ryfu2/Fall2024ECE445Team33/README.md

# Fall2024ECE445Team33
We are Team33 and this is our git repo for our ECE445 project:

AMADEUS

Augmented Modular AI Dialogue and Exchange User System 

It contains all the files/codes we have created and notes we have taken

There are more details in our design document, feel free to look around!
