ryfu2/Fall2024ECE445Team33/Python_code/wav_receiver/README.md

This code is for receiving wav file from the board through serial port.

It is used to verify that we packed input audio into a wav file correctly.
