ryfu2/Fall2024ECE445Team33/Documents/ECE445 Components.xlsx

Component | Functionality | Data Sheet | Purchase Link
ESP32-S3-WROOM-1 | ESP32 Microprocessor | https://www.espressif.com/sites/ default/files/documentation/ esp32-s3-wroom-1_wroom-1u_datasheet_en.pdf (https://www.espressif.com/sites/default/files/documentation/esp32-s3-wroom-1_wroom-1u_datasheet_en.pdf) | https://www.digikey.com/en/products/detail/espressif-systems/ ESP32-S3-WROOM-1-N8/15200089
TC1262 - 33 | 5V - 3.3V LDO | http://ww1.microchip.com/downloads/ en/DeviceDoc/21373C.pdf (http://ww1.microchip.com/downloads/en/DeviceDoc/21373C.pdf) | https://www.digikey.com/en/products/detail/ microchip-technology/TC1262-3-3VDBTR/443194
USB4085 | USBC Receptacle | https://gct.co/files/drawings/usb4085.pdf | https://www.digikey.com/en/products/detail/gct/USB4085-GF-A/9859662
INMP441 | Microphone | https://invensense.tdk.com/wp-content/ uploads/2015/02/INMP441.pdf | https://www.digikey.com/en/products/detail/tdk-invensense/INMP441ACEZ-R7/2793284
MAX98357A | Digital Audio Amplifier | https://www.analog.com/media/en/technical- documentation/data-sheets/max98357a-max98357b.pdf | https://www.digikey.com/en/products/detail/ analog-devices-inc-maxim-integrated/MAX98357AETE-T/4936122
LCD 1602 | LCD Display | https://universal-solder.ca/downloads/ canaduino_lcd_1602_datasheet.pdf | https://www.digikey.com/en/products/detail/universal-solder-electronics-ltd/ LCD-1602-2x16-Blue-White/16821383 (https://www.waveshare.com/datasheet/LCD_en_PDF/LCD1602.pdf)
OLED 128x64 1.3" I2C | 128 * 64 OLED Display | https://universal-solder.ca/downloads/ canaduino_oled_1.3_i2c.pdf | https://www.digikey.com/en/products/detail/universal-solder-electronics-ltd/ OLED-128x64-1-3-I2C/16822118
333028 | Serial Debug Port | https://mm.digikey.com/Volume0/opasdata/d220001/medias/docus/ 5858/333028%20USB%20UART%20CH340%20converter %20board%20datasheet.pdf?_gl=1*1krdu72*_up*MQ..&g clid=Cj0KCQjwu-63BhC9ARIsAMMTLXQhOa8hMw5uQejYv3aZm1 JxY8sn3Z-aL62KJKSncHDBArILaI2MEHUaAsvMEALw_wcB | https://www.digikey.com/en/products/detail/soldered-electronics/333028/21720459?gad_source=1
SP-1504 | Speaker | https://www.soberton.com/wp-content/uploads/2018/07/SP-1504-June-2018.pdf | https://www.digikey.com/en/products/detail/soberton-inc/SP-1504/3973690
Useful Links
Title | Link
Sound with ESP32 – I2S Protocol | https://dronebotworkshop.com/esp32-i2s/
ThingPulse OLED SSD1306 (ESP8266/ESP32/Mbed-OS) | https://github.com/ThingPulse/ esp8266-oled-ssd1306 (https://github.com/ThingPulse/esp8266-oled-ssd1306)
