ryfu2/Fall2024ECE445Team33/Arduino_code/microphone_input_wav_test/README.md

This is the Arduino code for testing audio input and wav file packaging.

It takes in audio input from microphone through I2S, package it into a wav file and send it through serial port.

Wav_receiver python file (serial_savewav.py) should be used to receive data from serial port to verify the wav file's validity.
