ryfu2/Fall2024ECE445Team33/Arduino_code/sine_wave_speaker_test/README.md

This is the Arduino code for test speaker audio output. 

It generates a sine wave signal and send it through I2S to the speaker.
