ryfu2/Fall2024ECE445Team33/Python_code/server_test/README.md

This code is for testing our AI server by sending requests to the server.

Input audio file is named 'record_out.wav' and response will be stored in 'response.wav'.
