ryfu2/Fall2024ECE445Team33/PCB/final_project/final_project_v0.1/final_project_v0.1.kicad_pcb

## KiCad design PCB/final_project/final_project_v0.1/final_project_v0.1.kicad_pcb (2024-12-04)

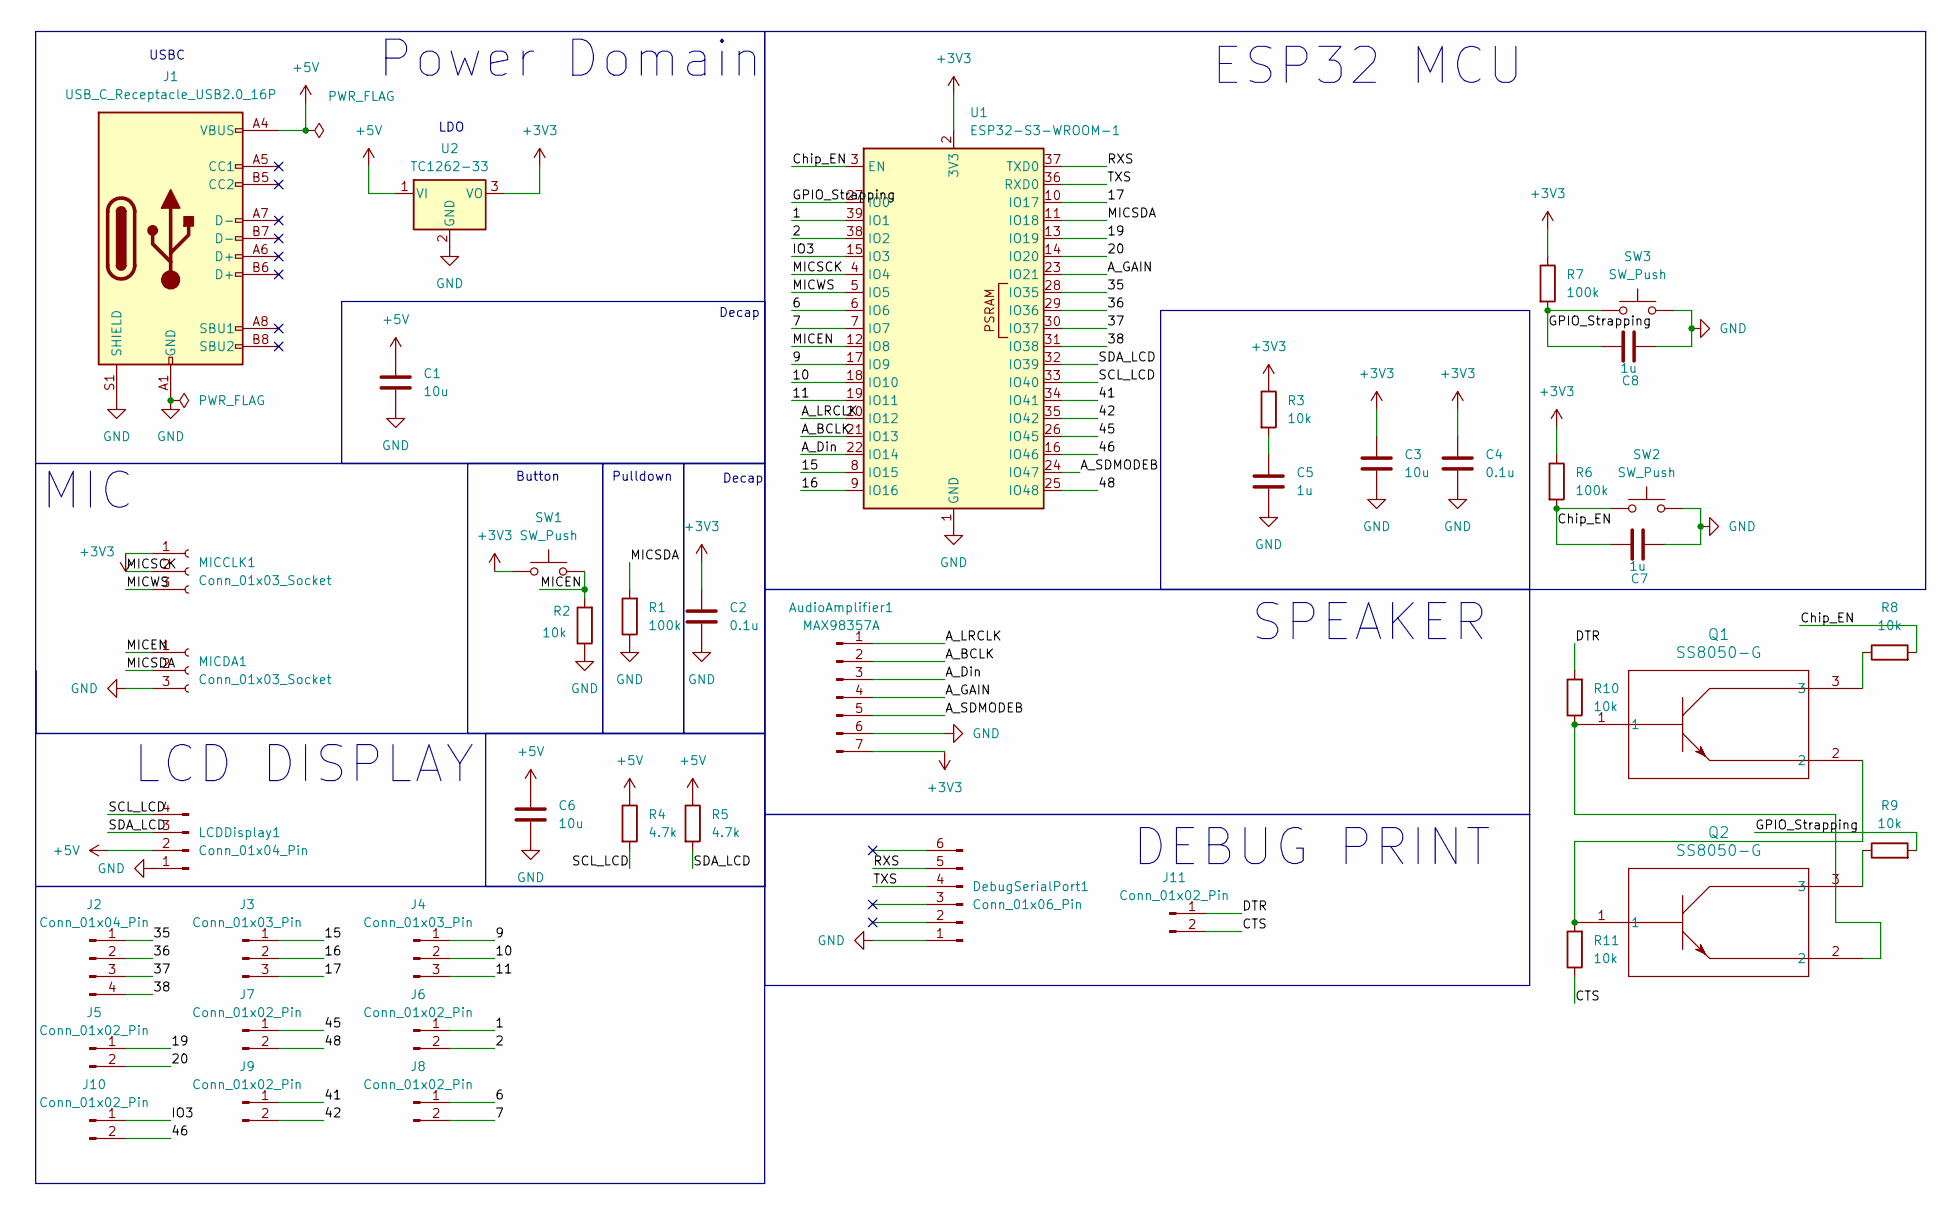
[picture p6: schematic final_project_v0.1.kicad_sch]

Parts:
AudioAmplifier1: MAX98357A; PinHeader_1x07_P2.54mm_Vertical
C1, C3, C6: 10u; C_0805_2012Metric_Pad1.18x1.45mm_HandSolder
C2, C4: 0.1u; C_0805_2012Metric_Pad1.18x1.45mm_HandSolder
C5, C7, C8: 1u; C_0805_2012Metric_Pad1.18x1.45mm_HandSolder
DebugSerialPort1: Conn_01x06_Pin; PinHeader_1x06_P2.54mm_Vertical
J1: USB_C_Receptacle_USB2.0_16P; USB_C_Receptacle_GCT_USB4085
J2: Conn_01x04_Pin; PinHeader_1x04_P2.54mm_Vertical
J3, J4: Conn_01x03_Pin; PinHeader_1x03_P2.54mm_Vertical
J5, J6, J7, J8, J9, J10, J11: Conn_01x02_Pin; PinHeader_1x02_P2.54mm_Vertical
LCDDisplay1: Conn_01x04_Pin; PinHeader_1x04_P2.54mm_Vertical
MICCLK1: Conn_01x03_Socket; PinHeader_1x03_P2.54mm_Vertical
MICDA1: Conn_01x03_Socket; PinHeader_1x03_P2.54mm_Vertical
Q1, Q2: SS8050-G; TRAN_SS8050-G_CIP
R1, R6, R7: 100k; R_0805_2012Metric_Pad1.20x1.40mm_HandSolder
R2, R3, R8, R9, R10, R11: 10k; R_0805_2012Metric_Pad1.20x1.40mm_HandSolder
R4, R5: 4.7k; R_0805_2012Metric_Pad1.20x1.40mm_HandSolder
SW1, SW2, SW3: SW_Push; SW_PUSH_6mm_H4.3mm
U1: ESP32-S3-WROOM-1
U2: TC1262-33; SOT-223-3_TabPin2

Connections:
+3V3: AudioAmplifier1.7, C2.1, C3.1, C4.1, MICCLK1.1, R3.1, R6.1, R7.1, SW1.1, U1.2 (3V3), U2.3 (VO)
+5V: C1.1, C6.1, J1.A4 (VBUS), J1.A9 (VBUS), J1.B4 (VBUS), J1.B9 (VBUS), LCDDisplay1.2, R4.1, R5.1, U2.1 (VI)
/1: J6.1, U1.39 (IO1)
/2: J6.2, U1.38 (IO2)
/6: J8.1, U1.6 (IO6)
/7: J8.2, U1.7 (IO7)
/9: J4.1, U1.17 (IO9)
/10: J4.2, U1.18 (IO10)
/11: J4.3, U1.19 (IO11)
/15: J3.1, U1.8 (IO15)
/16: J3.2, U1.9 (IO16)
/17: J3.3, U1.10 (IO17)
/19: J5.1, U1.13 (IO19)
/20: J5.2, U1.14 (IO20)
/35: J2.1, U1.28 (IO35)
/36: J2.2, U1.29 (IO36)
/37: J2.3, U1.30 (IO37)
/38: J2.4, U1.31 (IO38)
/41: J9.1, U1.34 (IO41)
/42: J9.2, U1.35 (IO42)
/45: J7.1, U1.26 (IO45)
/46: J10.2, U1.16 (IO46)
/48: J7.2, U1.25 (IO48)
/A_BCLK: AudioAmplifier1.2, U1.21 (IO13)
/A_Din: AudioAmplifier1.3, U1.22 (IO14)
/A_GAIN: AudioAmplifier1.4, U1.23 (IO21)
/A_LRCLK: AudioAmplifier1.1, U1.20 (IO12)
/A_SDMODEB: AudioAmplifier1.5, U1.24 (IO47)
/CTS: J11.2, R11.1
/Chip_EN: C7.1, R6.2, R8.2, SW2.1, U1.3 (EN)
/DTR: J11.1, R10.2
/GPIO_Strapping: C8.1, R7.2, R9.2, SW3.1, U1.27 (IO0)
/IO3: J10.1, U1.15 (IO3)
/MICEN: MICDA1.1, R2.2, SW1.2, U1.12 (IO8)
/MICSCK: MICCLK1.2, U1.4 (IO4)
/MICSDA: MICDA1.2, R1.2, U1.11 (IO18)
/MICWS: MICCLK1.3, U1.5 (IO5)
/RXS: DebugSerialPort1.5, U1.37 (TXD0)
/SCL_LCD: LCDDisplay1.4, R4.2, U1.33 (IO40)
/SDA_LCD: LCDDisplay1.3, R5.2, U1.32 (IO39)
/TXS: DebugSerialPort1.4, U1.36 (RXD0)
GND: AudioAmplifier1.6, C1.2, C2.2, C3.2, C4.2, C5.2, C6.2, C7.2, C8.2, DebugSerialPort1.1, J1.A1 (GND), J1.A12 (GND), J1.B1 (GND), J1.B12 (GND), J1.S1 (SHIELD), LCDDisplay1.1, MICDA1.3, R1.1, R2.1, SW2.2, SW3.2, U1.1 (GND), U1.40 (GND), U1.41 (GND), U2.2 (GND)
unnamed: C5.1, R3.2
unnamed: Q1.1, Q2.2, R10.1
unnamed: Q1.2, Q2.1, R11.2
unnamed: Q1.3, R8.1
unnamed: Q2.3, R9.1

Notes on the sheet:
LCD DISPLAY
Decap
Power Domain
Button
USBC
ESP32 MCU
MIC
LDO
SPEAKER
DEBUG PRINT
Pulldown

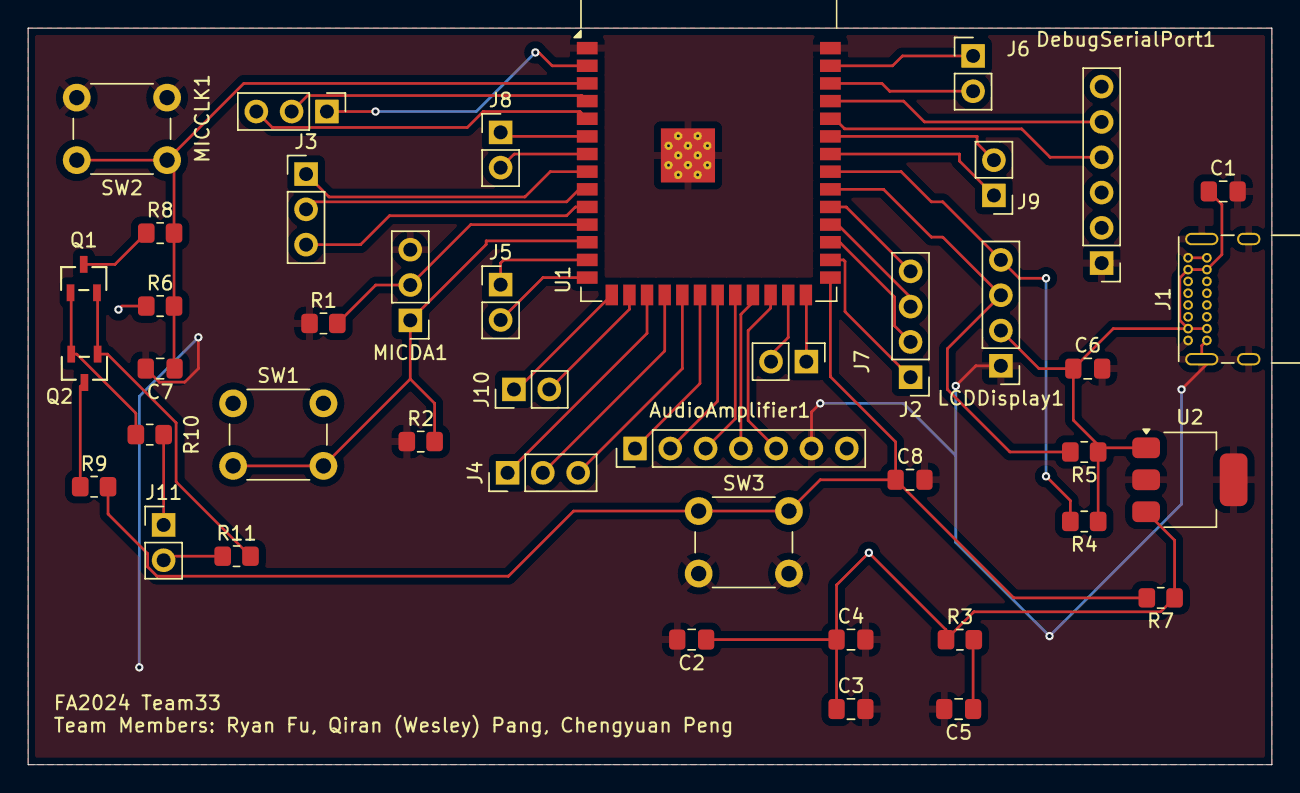
[picture p7: board final_project_v0.1.kicad_pcb from above]

Board: 2 copper layers, 89.5 x 53.0 mm, 42 parts (0 on the bottom side), 47 nets.
