ryfu2/Fall2024ECE445Team33/Arduino_code/final_code/oled.cpp

#include <Arduino.h>
#include "oled.h"

static const uint8_t oled_font6x8 [] PROGMEM = {
    0x00, 0x00, 0x00, 0x00, 0x00, 0x00, // sp
    0x00, 0x00, 0x00, 0x2f, 0x00, 0x00, // !
    0x00, 0x00, 0x07, 0x00, 0x07, 0x00, // "
    0x00, 0x14, 0x7f, 0x14, 0x7f, 0x14, // #
    0x00, 0x24, 0x2a, 0x7f, 0x2a, 0x12, // $
    0x00, 0x62, 0x64, 0x08, 0x13, 0x23, // %
    0x00, 0x36, 0x49, 0x55, 0x22, 0x50, // &
    0x00, 0x00, 0x05, 0x03, 0x00, 0x00, // '
    0x00, 0x00, 0x1c, 0x22, 0x41, 0x00, // (
    0x00, 0x00, 0x41, 0x22, 0x1c, 0x00, // )
    0x00, 0x14, 0x08, 0x3E, 0x08, 0x14, // *
    0x00, 0x08, 0x08, 0x3E, 0x08, 0x08, // +
    0x00, 0x00, 0x00, 0xA0, 0x60, 0x00, // ,
    0x00, 0x08, 0x08, 0x08, 0x08, 0x08, // -
    0x00, 0x00, 0x60, 0x60, 0x00, 0x00, // .
    0x00, 0x20, 0x10, 0x08, 0x04, 0x02, // /
    0x00, 0x3E, 0x51, 0x49, 0x45, 0x3E, // 0
    0x00, 0x00, 0x42, 0x7F, 0x40, 0x00, // 1
    0x00, 0x42, 0x61, 0x51, 0x49, 0x46, // 2
    0x00, 0x21, 0x41, 0x45, 0x4B, 0x31, // 3
    0x00, 0x18, 0x14, 0x12, 0x7F, 0x10, // 4
    0x00, 0x27, 0x45, 0x45, 0x45, 0x39, // 5
    0x00, 0x3C, 0x4A, 0x49, 0x49, 0x30, // 6
    0x00, 0x01, 0x71, 0x09, 0x05, 0x03, // 7
    0x00, 0x36, 0x49, 0x49, 0x49, 0x36, // 8
    0x00, 0x06, 0x49, 0x49, 0x29, 0x1E, // 9
    0x00, 0x00, 0x36, 0x36, 0x00, 0x00, // :
    0x00, 0x00, 0x56, 0x36, 0x00, 0x00, // ;
    0x00, 0x08, 0x14, 0x22, 0x41, 0x00, // <
    0x00, 0x14, 0x14, 0x14, 0x14, 0x14, // =
    0x00, 0x00, 0x41, 0x22, 0x14, 0x08, // >
    0x00, 0x02, 0x01, 0x51, 0x09, 0x06, // ?
    0x00, 0x32, 0x49, 0x59, 0x51, 0x3E, // @
    0x00, 0x7C, 0x12, 0x11, 0x12, 0x7C, // A
    0x00, 0x7F, 0x49, 0x49, 0x49, 0x36, // B
    0x00, 0x3E, 0x41, 0x41, 0x41, 0x22, // C
    0x00, 0x7F, 0x41, 0x41, 0x22, 0x1C, // D
    0x00, 0x7F, 0x49, 0x49, 0x49, 0x41, // E
    0x00, 0x7F, 0x09, 0x09, 0x09, 0x01, // F
    0x00, 0x3E, 0x41, 0x49, 0x49, 0x7A, // G
    0x00, 0x7F, 0x08, 0x08, 0x08, 0x7F, // H
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
    0x02, 0x04, 0x08, 0x10, 0x20, 0x00, // backslash
    0x00, 0x00, 0x41, 0x41, 0x7F, 0x00, // ]
    0x00, 0x04, 0x02, 0x01, 0x02, 0x04, // ^
    0x00, 0x40, 0x40, 0x40, 0x40, 0x40, // _
    0x00, 0x00, 0x01, 0x02, 0x04, 0x00, // '
    0x00, 0x20, 0x54, 0x54, 0x54, 0x78, // a
    0x00, 0x7F, 0x48, 0x44, 0x44, 0x38, // b
    0x00, 0x38, 0x44, 0x44, 0x44, 0x20, // c
    0x00, 0x38, 0x44, 0x44, 0x48, 0x7F, // d
    0x00, 0x38, 0x54, 0x54, 0x54, 0x18, // e
    0x00, 0x08, 0x7E, 0x09, 0x01, 0x02, // f
    0x00, 0x18, 0xA4, 0xA4, 0xA4, 0x7C, // g
    0x00, 0x7F, 0x08, 0x04, 0x04, 0x78, // h
    0x00, 0x00, 0x44, 0x7D, 0x40, 0x00, // i
    0x00, 0x40, 0x80, 0x84, 0x7D, 0x00, // j
    0x00, 0x7F, 0x10, 0x28, 0x44, 0x00, // k
    0x00, 0x00, 0x41, 0x7F, 0x40, 0x00, // l
    0x00, 0x7C, 0x04, 0x18, 0x04, 0x78, // m
    0x00, 0x7C, 0x08, 0x04, 0x04, 0x78, // n
    0x00, 0x38, 0x44, 0x44, 0x44, 0x38, // o
    0x00, 0xFC, 0x24, 0x24, 0x24, 0x18, // p
    0x00, 0x18, 0x24, 0x24, 0x18, 0xFC, // q
    0x00, 0x7C, 0x08, 0x04, 0x04, 0x08, // r
    0x00, 0x48, 0x54, 0x54, 0x54, 0x20, // s
    0x00, 0x04, 0x3F, 0x44, 0x40, 0x20, // t
    0x00, 0x3C, 0x40, 0x40, 0x20, 0x7C, // u
    0x00, 0x1C, 0x20, 0x40, 0x20, 0x1C, // v
    0x00, 0x3C, 0x40, 0x30, 0x40, 0x3C, // w
    0x00, 0x44, 0x28, 0x10, 0x28, 0x44, // x
    0x00, 0x1C, 0xA0, 0xA0, 0xA0, 0x7C, // y
    0x00, 0x44, 0x64, 0x54, 0x4C, 0x44, // z
    0x00, 0x00, 0x08, 0x77, 0x41, 0x00, // {
    0x00, 0x00, 0x00, 0x63, 0x00, 0x00, // ¦
    0x00, 0x00, 0x41, 0x77, 0x08, 0x00, // }
    0x00, 0x08, 0x04, 0x08, 0x08, 0x04, // ~
    0x00, 0x3D, 0x40, 0x40, 0x20, 0x7D, // ü
    0x00, 0x3D, 0x40, 0x40, 0x40, 0x3D, // Ü
    0x00, 0x21, 0x54, 0x54, 0x54, 0x79, // ä
    0x00, 0x7D, 0x12, 0x11, 0x12, 0x7D, // Ä
    0x00, 0x39, 0x44, 0x44, 0x44, 0x39, // ö
    0x00, 0x3D, 0x42, 0x42, 0x42, 0x3D, // Ö
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
};

OLED::OLED(uint8_t sda_pin, uint8_t scl_pin, uint8_t reset_pin, uint8_t i2c_address, uint_fast8_t width, uint_fast8_t height, bool isSH1106) :
sda_pin(sda_pin),
scl_pin(scl_pin),
reset_pin(reset_pin),
width(width),
height(height),
i2c_address(i2c_address),
pages((height + 7) / 8),
bufsize(static_cast<uint_least16_t> (pages*width))
{
    this->buffer = (uint8_t *) malloc(bufsize); // two dimensional array of n pages each of n columns.
    X=0;
    Y=0;
    ttyMode=OLED_DEFAULT_TTY_MODE;
    if (isSH1106) {
        displayController=CTRL_SH1106;
    }
    else {
        displayController=CTRL_SSD1306;
    }
    fontInverted=false;
    usingOffset=false;
}

OLED::OLED(uint8_t sda_pin, uint8_t scl_pin, uint8_t reset_pin, tWidth width, tHeight height, tDisplayCtrl displayCtrl, uint8_t i2c_address) :
sda_pin(sda_pin),
scl_pin(scl_pin),
reset_pin(reset_pin),
width(width),
height(height),
i2c_address(i2c_address),
displayController(displayCtrl),
pages((height + 7) / 8),
bufsize(static_cast<uint_least16_t> (pages*width))
{
    this->buffer = (uint8_t *) malloc(bufsize); // two dimensional array of n pages each of n columns.
    X=0;
    Y=0;
    ttyMode=OLED_DEFAULT_TTY_MODE;
    fontInverted=false;
    usingOffset=false;
}

OLED::~OLED()
{
    free(buffer);
}

void OLED::i2c_start()
{
    while (!digitalRead(sda_pin) || !digitalRead(scl_pin));
    digitalWrite(sda_pin, LOW);
    #if !defined OUTPUT_OPEN_DRAIN
        pinMode(sda_pin, OUTPUT);
    #endif
        OLED_I2C_DELAY;
        digitalWrite(scl_pin, LOW);
    #if !defined OUTPUT_OPEN_DRAIN
        pinMode(scl_pin, OUTPUT);
    #endif
    OLED_I2C_DELAY;
}

void OLED::i2c_stop()
{
    #if !defined OUTPUT_OPEN_DRAIN
        pinMode(scl_pin, INPUT);
    #endif
        digitalWrite(scl_pin, HIGH);
        OLED_I2C_DELAY;
    #if !defined OUTPUT_OPEN_DRAIN
        pinMode(sda_pin, INPUT);
    #endif
    digitalWrite(sda_pin, HIGH);
    OLED_I2C_DELAY;
    while (!digitalRead(sda_pin) || !digitalRead(scl_pin));
}

bool OLED::i2c_send(uint8_t byte)
{
    for (int_fast8_t bit = 7; bit >= 0; bit--)
    {
        if (byte & 128)
        {
        #if !defined OUTPUT_OPEN_DRAIN
                    pinMode(sda_pin, INPUT);
        #endif
                    digitalWrite(sda_pin, HIGH);
                }
                else
                {
                    digitalWrite(sda_pin, LOW);
        #if !defined OUTPUT_OPEN_DRAIN
                    pinMode(sda_pin, OUTPUT);
        #endif
        }
        OLED_I2C_DELAY;
        #if !defined OUTPUT_OPEN_DRAIN
                pinMode(scl_pin, INPUT);
        #endif
                digitalWrite(scl_pin, HIGH);        
                OLED_I2C_DELAY;
                while (!digitalRead(scl_pin)); 
                digitalWrite(scl_pin, LOW);
        #if !defined OUTPUT_OPEN_DRAIN
                pinMode(scl_pin, OUTPUT);
        #endif
        OLED_I2C_DELAY;
        byte = byte << 1;
    }
    // Receive ACK
    #if !defined OUTPUT_OPEN_DRAIN
        pinMode(sda_pin, INPUT);
    #endif
        digitalWrite(sda_pin, HIGH);
    #if !defined OUTPUT_OPEN_DRAIN
        pinMode(scl_pin, INPUT);
    #endif
    digitalWrite(scl_pin, HIGH);    
    OLED_I2C_DELAY;
    while (!digitalRead(scl_pin)); 
    bool ack = digitalRead(sda_pin) == 0;    
    digitalWrite(scl_pin, LOW);
    #if !defined OUTPUT_OPEN_DRAIN
        pinMode(scl_pin, OUTPUT);
    #endif
    OLED_I2C_DELAY;
    return ack;
}

void OLED::begin()
{
    #if defined OUTPUT_OPEN_DRAIN
        pinMode(sda_pin, OUTPUT_OPEN_DRAIN);
        digitalWrite(sda_pin, HIGH);
        pinMode(scl_pin, OUTPUT_OPEN_DRAIN);
        digitalWrite(scl_pin, HIGH);
    #else
        pinMode(sda_pin, INPUT);
        pinMode(scl_pin, INPUT);
    #endif
    if (reset_pin != NO_RESET_PIN)
    {
        pinMode(reset_pin, OUTPUT);
        digitalWrite(reset_pin, LOW);
        delay(10);
        digitalWrite(reset_pin, HIGH);
    }
    delay(100);
    i2c_start();
    i2c_send(i2c_address << 1); // address + write
    i2c_send(0x00); // command
    i2c_send(0xAE); // display off
    i2c_send(0xD5); // clock divider
    i2c_send(0x80); 
    i2c_send(0xA8); // multiplex ratio
    i2c_send(height - 1); 
    i2c_send(0xD3); // no display offset
    i2c_send(0x00); 
    i2c_send(0x40); // start line address=0
    i2c_send(0x8D); // enable charge pump
    i2c_send(0x14); 
    i2c_send(0x20); // memory adressing mode=horizontal
    i2c_send(0x00); 
    i2c_send(0xA1); // segment remapping mode
    i2c_send(0xC8); // COM output scan direction
    if (width == 128 && height == 32)
    {
        i2c_send(0xDA); // com pins hardware configuration
        i2c_send(0x02); 
    }
    else if (width == 128 && height == 64)
    {
        i2c_send(0xDA); // com pins hardware configuration
        i2c_send(0x12); 
    }
    else if (width == 96 && height == 16)
    {
        i2c_send(0xDA); // com pins hardware configuration
        i2c_send(0x02); 
    }
    i2c_send(0x81); // contrast control
    i2c_send(0x80);
    i2c_send(0xD9); // pre-charge period
    i2c_send(0x22); 
    i2c_send(0xDB); // set vcomh deselect level
    i2c_send(0x20); 
    i2c_send(0xA4); // output RAM to display
    i2c_send(0xA6); // display mode A6=normal, A7=inverse
    i2c_send(0x2E); // stop scrolling
    i2c_stop();
    delay(100);

    // Clear and send buffer
    display();
    clear();
    display();

    // Switch display on
    set_power(true);
}

void OLED::set_power(bool enable)
{
    i2c_start();
    i2c_send(i2c_address << 1); // address + write
    i2c_send(0x00); // command
    if (enable)
    {
        i2c_send(0x8D); // enable charge pump
        i2c_send(0x14);
        i2c_send(0xAF); // display on
    }
    else
    {
        i2c_send(0xAE); // display off
        i2c_send(0x8D); // disable charge pump
        i2c_send(0x10);
    }
    i2c_stop();
}

void OLED::set_invert(bool enable)
{
    i2c_start();
    i2c_send(i2c_address << 1); // address + write
    i2c_send(0x00); // command
    if (enable)
    {
        i2c_send(0xA7); // invert display
    }
    else
    {
        i2c_send(0xA6); // normal display
    }
    i2c_stop();
}

void OLED::set_scrolling(tScrollEffect scroll_type, uint_fast8_t first_page, uint_fast8_t last_page)
{
    i2c_start();
    i2c_send(i2c_address << 1); // address + write
    i2c_send(0x00); // command
    i2c_send(0x2E); // deativate scroll
    if (scroll_type == DIAGONAL_LEFT || scroll_type == DIAGONAL_RIGHT)
    {
        i2c_send(0xA3); // vertical scroll area
        i2c_send(0x00);
        i2c_send(height - 1);
    }
    if (scroll_type != NO_SCROLLING)
    {
        i2c_send(scroll_type);
        i2c_send(0x00); // dummy byte
        i2c_send(first_page);
        i2c_send(0x00); // time interval
        i2c_send(last_page);
        if (scroll_type == DIAGONAL_LEFT || scroll_type == DIAGONAL_RIGHT)
        {
            i2c_send(0x01); // vertical scrolling speed
        }
        else
        {
            i2c_send(0x00); // dummy byte
            i2c_send(0xFF); // dummy byte
        }
        i2c_send(0x2F); // ativate scroll
    }
    i2c_stop();
}

void OLED::set_contrast(uint8_t contrast)
{
    i2c_start();
    i2c_send(i2c_address << 1); // address + write
    i2c_send(0x00); // command
    i2c_send(0x81); // deativate scrol
    i2c_send(contrast); 
    i2c_stop();
}

void OLED::clear(tColor color)
{
    if (color == WHITE)
    {
        memset(buffer, 0xFF, bufsize);
    }
    else
    {
        memset(buffer, 0x00, bufsize);
    }
    X=0;
    Y=0;
}

void OLED::display()
{
    uint16_t index = 0;
    for (uint_fast8_t page = 0; page < pages; page++)
    {
        // Set memory address to fill
        i2c_start();
        i2c_send(i2c_address << 1); // address + write
        i2c_send(0x00); // command
        if (displayController == CTRL_SH1106)
        {
            i2c_send(0xB0 + page); // set page
            i2c_send(0x00); // lower columns address =0
            i2c_send(0x10); // upper columns address =0
        }
        else
        {
            i2c_send(0xB0 + page); // set page
            i2c_send(0x21); // column address
            i2c_send(0x00); // first column =0
            i2c_send(width - 1); // last column
        }
        i2c_stop();

        // send one page of buffer to the display
        i2c_start();
        i2c_send(i2c_address << 1); // address + write
        i2c_send(0x40); // data
        if(usingOffset){
            i2c_send(0);
            i2c_send(0);
        }
        for (uint_fast8_t column = 0; column < width; column++)
        {
            i2c_send(buffer[index++]);
        }
        i2c_stop();
        yield(); // to avoid that the watchdog triggers
    }
}

void OLED::draw_byte(uint_fast8_t x, uint_fast8_t y, uint8_t b, tColor color)
{
    // Invalid position
    if (x >= width || y >= height)
    {
        return;
    }

    uint_fast16_t buffer_index = y / 8 * width + x;

    if (fontInverted) {
        b^=255;
    }

    if (color == WHITE)
    {
        // If the y position matches a page, then it goes quicker
        if (y % 8 == 0)
        {
            if (buffer_index < bufsize)
            {
                buffer[buffer_index] |= b;
            }
        }
        else
        {
            uint16_t w = (uint16_t) b << (y % 8);
            if (buffer_index < bufsize)
            {
                buffer[buffer_index] |= (w & 0xFF);
            }
            uint16_t buffer_index2 = buffer_index + width;
            if (buffer_index2 < bufsize)
            {
                buffer[buffer_index2] |= (w >> 8);
            }
        }
    }
    else
    {
        // If the y position matches a page, then it goes quicker
        if (y % 8 == 0)
        {
            if (buffer_index < bufsize)
            {
                buffer[buffer_index] &= ~b;
            }
        }
        else
        {
            uint16_t w = (uint16_t) b << (y % 8);
            if (buffer_index < bufsize)
            {
                buffer[buffer_index] &= ~(w & 0xFF);
            }
            uint16_t buffer_index2 = buffer_index + width;
            if (buffer_index2 < bufsize)
            {
                buffer[buffer_index2] &= ~(w >> 8);
            }
        }
    }
    return;
}

void OLED::draw_bytes(uint_fast8_t x, uint_fast8_t y, const uint8_t* data, uint_fast8_t size, tFontScaling scaling, tColor color, bool useProgmem)
{
    for (uint_fast8_t column = 0; column < size; column++)
    {
        uint8_t b;
        if (useProgmem)
        {
            b = pgm_read_byte(data);
        }
        else
        {
            b = *data;
        }
        data++;
        if (scaling == DOUBLE_SIZE)
        {
            // Stretch vertically
            uint16_t w = 0;
            for (uint_fast8_t bit = 0; bit < 7; bit++)
            {
                if (b & (1 << bit))
                {
                    uint_fast8_t pos = bit << 1;
                    w |= ((1 << pos) | (1 << (pos + 1)));
                }
            }

            // Output 2 times to strech hozizontally            
            draw_byte(x, y, w & 0xFF, color);
            draw_byte(x, y + 8, (w >> 8), color);
            x++;
            draw_byte(x, y, w & 0xFF, color);
            draw_byte(x, y + 8, (w >> 8), color);
            x++;
        }
        else // NORMAL_SIZE
        {
            draw_byte(x++, y, b, color);
        }
    }
}

size_t OLED::draw_character(uint_fast8_t x, uint_fast8_t y, char c, tFontScaling scaling, tColor color)
{
    // Invalid position
    if (x >= width || y >= height || c < 32)
    {
        return 0;
    }

    // Remap extended Latin1 character codes
    switch ((unsigned char) c)
    {
        case 252 /* u umlaut */:
            c = 127;
            break;
        case 220 /* U umlaut */:
            c = 128;
            break;
        case 228 /* a umlaut */:
            c = 129;
            break;
        case 196 /* A umlaut */:
            c = 130;
            break;
        case 246 /* o umlaut */:
            c = 131;
            break;
        case 214 /* O umlaut */:
            c = 132;
            break;
        case 176 /* degree   */:
            c = 133;
            break;
        case 223 /* szlig    */:
            c = 134;
            break;
    }

    uint16_t font_index = (c - 32)*6;

    // Invalid character code/font index
    if (font_index >= sizeof (oled_font6x8))
    {
        return 0;
    }

    draw_bytes(x, y, &oled_font6x8[font_index], 6, scaling, color, true);
    return 1;
}

void OLED::draw_string(uint_fast8_t x, uint_fast8_t y, const char* s, tFontScaling scaling, tColor color)
{
    while (*s)
    {
        draw_character(x, y, *s, scaling, color);
        if (scaling == DOUBLE_SIZE)
        {
            x += 12;
        }
        else // NORMAL_SIZE
        {
            x += 6;
        }
        s++;
    }
}

void OLED::draw_string_P(uint_fast8_t x, uint_fast8_t y, const char* s, tFontScaling scaling, tColor color)
{
    char c;
    while ((c = pgm_read_byte(s)))
    {
        draw_character(x, y, c, scaling, color);
        if (scaling == DOUBLE_SIZE)
        {
            x += 12;
        }
        else // NORMAL_SIZE
        {
            x += 6;
        }
        s++;
    }
}

void OLED::draw_bitmap(uint_fast8_t x, uint_fast8_t y, uint_fast8_t bitmap_width, uint_fast8_t bitmap_height, const uint8_t* data, tColor color)
{
    uint_fast8_t num_pages = (bitmap_height + 7) / 8;
    for (uint_fast8_t page = 0; page < num_pages; page++)
    {
        draw_bytes(x, y, data, bitmap_width, NORMAL_SIZE, color, false);
        data += bitmap_width;
        y += 8;
    }
}

void OLED::draw_bitmap_P(uint_fast8_t x, uint_fast8_t y, uint_fast8_t bitmap_width, uint_fast8_t bitmap_height, const uint8_t* data, tColor color)
{
    uint_fast8_t num_pages = (bitmap_height + 7) / 8;
    for (uint_fast8_t page = 0; page < num_pages; page++)
    {
        draw_bytes(x, y, data, bitmap_width, NORMAL_SIZE, color, true);
        data += bitmap_width;
        y += 8;
    }
}

void OLED::draw_pixel(uint_fast8_t x, uint_fast8_t y, tColor color)
{
    if (x >= width || y >= height)
    {
        return;
    }
    if (color == WHITE)
    {
        buffer[x + (y / 8) * width] |= (1 << (y & 7)); // set bit 
    }
    else
    {
        buffer[x + (y / 8) * width] &= ~(1 << (y & 7)); // clear bit
    }
}

void OLED::draw_line(uint_fast8_t x0, uint_fast8_t y0, uint_fast8_t x1, uint_fast8_t y1, tColor color)
{        
    // Algorithm copied from Wikipedia
    int_fast16_t dx = abs(static_cast<int_fast16_t>(x1) - static_cast<int_fast16_t>(x0));
    int_fast16_t sx = x0 < x1 ? 1 : -1;
    int_fast16_t dy = -abs(static_cast<int_fast16_t>(y1) - static_cast<int_fast16_t>(y0));
    int_fast16_t sy = y0 < y1 ? 1 : -1;
    int_fast16_t err = dx + dy;
    int_fast16_t e2;

    while (1)
    {
        draw_pixel(x0, y0, color);
        if (x0 == x1 && y0 == y1)
        {
            break;
        }
        e2 = 2 * err;
        if (e2 > dy)
        {
            err += dy;
            x0 += sx;
        }
        if (e2 < dx)
        {
            err += dx;
            y0 += sy;
        }
    }
}

void OLED::draw_circle(uint_fast8_t x0, uint_fast8_t y0, uint_fast8_t radius, tFillmode fillMode, tColor color)
{
    // Algorithm copied from Wikipedia
    int_fast16_t f = 1 - radius;
    int_fast16_t ddF_x = 0;
    int_fast16_t ddF_y = -2 * radius;
    int_fast16_t x = 0;
    int_fast16_t y = radius;

    if (fillMode == SOLID)
    {
        draw_pixel(x0, y0 + radius, color);
        draw_pixel(x0, y0 - radius, color);
        draw_line(x0 - radius, y0, x0 + radius, y0, color);
    }
    else
    {
        draw_pixel(x0, y0 + radius, color);
        draw_pixel(x0, y0 - radius, color);
        draw_pixel(x0 + radius, y0, color);
        draw_pixel(x0 - radius, y0, color);
    }

    while (x < y)
    {
        if (f >= 0)
        {
            y--;
            ddF_y += 2;
            f += ddF_y;
        }
        x++;
        ddF_x += 2;
        f += ddF_x + 1;

        if (fillMode == SOLID)
        {
            draw_line(x0 - x, y0 + y, x0 + x, y0 + y, color);
            draw_line(x0 - x, y0 - y, x0 + x, y0 - y, color);
            draw_line(x0 - y, y0 + x, x0 + y, y0 + x, color);
            draw_line(x0 - y, y0 - x, x0 + y, y0 - x, color);
        }
        else
        {
            draw_pixel(x0 + x, y0 + y, color);
            draw_pixel(x0 - x, y0 + y, color);
            draw_pixel(x0 + x, y0 - y, color);
            draw_pixel(x0 - x, y0 - y, color);
            draw_pixel(x0 + y, y0 + x, color);
            draw_pixel(x0 - y, y0 + x, color);
            draw_pixel(x0 + y, y0 - x, color);
            draw_pixel(x0 - y, y0 - x, color);
        }
    }
}

void OLED::draw_rectangle(uint_fast8_t x0, uint_fast8_t y0, uint_fast8_t x1, uint_fast8_t y1, tFillmode fillMode, tColor color)
{
    // Swap x0 and x1 if in wrong order
    if (x0 > x1)
    {
        uint_fast8_t tmp = x0;
        x0 = x1;
        x1 = tmp;
    }
    // Swap y0 and y1 if in wrong order
    if (y0 > y1)
    {
        uint_fast8_t tmp = y0;
        y0 = y1;
        y1 = tmp;
    }
    if (fillMode == SOLID)
    {        
        for (uint_fast8_t y = y0; y <= y1; y++)
        {
            draw_line(x0, y, x1, y, color);
        }
    }
    else
    {
        draw_line(x0, y0, x1, y0, color);
        draw_line(x0, y1, x1, y1, color);
        draw_line(x0, y0, x0, y1, color);
        draw_line(x1, y0, x1, y1, color);
    }
}

void OLED::scroll_up(uint_fast8_t num_lines, uint_fast8_t delay_ms)
{
    if (delay_ms == 0)
    {
        // Scroll full pages, fast algorithm
        uint_fast8_t scroll_pages = num_lines / 8;
        for (uint_fast8_t i = 0; i < pages; i++)
        {
            for (uint_fast8_t x = 0; x < width; x++)
            {
                uint16_t index = i * width + x;
                uint16_t index2 = (i + scroll_pages) * width + x;
                if (index2 < bufsize)
                {
                    buffer[index] = buffer[index2];
                }
                else
                {
                    buffer[index] = 0;
                }
            }
        }
        num_lines -= scroll_pages * 8;
    }

    // Scroll the remainder line by line 
    bool need_refresh=true;
    if (num_lines > 0)
    {
        uint16_t start=millis() & 0xFFFF;
        uint16_t target_time=0;
        
        for (uint_fast8_t i = 0; i < num_lines; i++)
        {

            // Scroll everything 1 line up            
            for (uint_fast8_t j = 0; j < pages; j++)
            {
                uint16_t index = j*width;
                uint16_t index2 = index + width;
                for (uint_fast8_t x = 0; x < width; x++)
                {
                    uint_fast8_t carry = 0;
                    if (index2 < bufsize)
                    {
                        if (buffer[index2] & 1)
                        {
                            carry = 128;
                        }
                    }
                    buffer[index] = (buffer[index] >> 1) | carry;
                    index++;
                    index2++;
                }
            }
            need_refresh=true;
            target_time+=delay_ms;
            
            // Refresh the display only if we have some time
            uint16_t now=millis() & 0xFFFF;
            if (now-start < target_time)
            {
                display();
                need_refresh=false;
            }
                       
            // If we have still more time, then yield a while
            while((millis() & 0xFFFF)-start < target_time)
            {
                yield();
            }
        }
    }
    
    if (need_refresh)
    {
        display();
    }
}

size_t OLED::write(uint8_t c)
{
	int n=1;
	n=draw_character(X,Y,c);
	X+=OLED_FONT_WIDTH;
	return n;
}

void OLED::setCursor(uint_fast8_t x, uint_fast8_t y)
{
	if (ttyMode) return; // in TTY mode position the cursor has no effect
	X=x;
	Y=y;
}

size_t OLED::printf(uint_fast8_t x, uint_fast8_t y, const char *format, ...) {
    va_list arg;
    va_start(arg, format);
    char temp[64];
    char* buffer = temp;
    size_t len = vsnprintf(temp, sizeof(temp), format, arg);
    va_end(arg);
    if (len > sizeof(temp) - 1) {
        buffer = new char[len + 1];
        if (!buffer) {
            return 0;
        }
        va_start(arg, format);
        vsnprintf(buffer, len + 1, format, arg);
        va_end(arg);
    }
    X=x;
    Y=y;
    len = write((const uint8_t*) buffer, len);
    if (buffer != temp) {
        delete[] buffer;
    }

    return len;
}

size_t OLED::printf(const char *format, ...) {
    va_list arg;
    va_start(arg, format);
    char temp[64];
    char* buffer = temp;
    size_t len = vsnprintf(temp, sizeof(temp), format, arg);
    va_end(arg);
    if (len > sizeof(temp) - 1) {
        buffer = new char[len + 1];
        if (!buffer) {
            return 0;
        }
        va_start(arg, format);
        vsnprintf(buffer, len + 1, format, arg);
        va_end(arg);
    }
    len = write((const uint8_t*) buffer, len);
    if (buffer != temp) {
        delete[] buffer;
    }

    return len;
}

size_t OLED::write(const uint8_t *buffer, size_t len)
{
    //size_t n = 0;
    for (size_t ix=0;ix<len;ix++)
    {
		// If CR and LF are found consecutive, only one is processed
    	// If two or more CR are consecutive, both are processed
    	// If two or more LF are consecutive, both are processed
    	if (buffer[ix] == '\r')
		{
    		X=0;
			Y+=(OLED_FONT_HEIGHT);
			if (buffer[ix+1] == '\n') {
				ix++; // skip char
			}
		}
		else if (buffer[ix] == '\n')
		{
			X=0;
			Y+=(OLED_FONT_HEIGHT);
			if (buffer[ix+1] == '\r') {
				ix++; // skip char
			}
		}
		else if (*(buffer+ix) == '\f')
		{
			// FORM FEED
			scroll_up(height);
			X=0;
			Y=0;
		}
		else
		{
			write(buffer[ix]);
		}

		if (ttyMode)
		{
			// Scroll up if cursor position is out of screen
			if (Y >= height)
			{
				scroll_up(OLED_FONT_HEIGHT);
				Y=height-OLED_FONT_HEIGHT;
			}
		}
    }
    if (ttyMode) display();
    return len;
}

void OLED::setTTYMode(bool enabled)
{
	ttyMode=enabled;
}

void OLED::useOffset(bool enabled)
{
    if(displayController == CTRL_SH1106){
        usingOffset=enabled;
    }
}

// ************************ U8g2 wrappers ************************
void OLED::drawString(uint_fast8_t col, uint_fast8_t row, const char* s, tFontScaling scaling, tColor color)
{
    draw_string(ToX(col),ToY(row),s,scaling,color);
}

void OLED::inverse(void)
{
    set_font_inverted(true);
}

void OLED::noInverse(void)
{
    set_font_inverted(false);
}

// ************************ Tools func ************************

void OLED::set_font_inverted(bool enabled)
{
    fontInverted=enabled;
}

uint_fast8_t OLED::ToCol(uint_fast8_t x)
{
    return(x/OLED_FONT_WIDTH);
}

uint_fast8_t OLED::ToRow(uint_fast8_t y)
{
    return(y/OLED_FONT_HEIGHT);
}

uint_fast8_t OLED::ToX(uint_fast8_t col)
{
    return(col*OLED_FONT_WIDTH);
}

uint_fast8_t OLED::ToY(uint_fast8_t row)
{
    return(row*OLED_FONT_HEIGHT);
}
