ryfu2/Fall2024ECE445Team33/Arduino_code/sine_wave_speaker_test/sine_wave_speaker_test.ino

/**
 * @file streams-generator-i2s.ino
 * @author Phil Schatzmann
 * @brief see https://github.com/pschatzmann/arduino-audio-tools/blob/main/examples/examples-stream/streams-generator-i2s/README.md 
 * @copyright GPLv3
 */
 
#include "AudioTools.h"

AudioInfo info(44100, 2, 16);
SineWaveGenerator<int16_t> sineWave(32000);                // subclass of SoundGenerator with max amplitude of 32000
GeneratedSoundStream<int16_t> sound(sineWave);             // Stream generated from sine wave
I2SStream out; 
StreamCopy copier(out, sound);                             // copies sound into i2s

// Arduino Setup
void setup(void) {  
  // Open Serial 
  Serial.begin(115200);
  while(!Serial);
  AudioLogger::instance().begin(Serial, AudioLogger::Info);

  // start I2S
  Serial.println("starting I2S...");
  auto config = out.defaultConfig(TX_MODE);
  config.copyFrom(info); 
  config.pin_bck = 11;
  config.pin_data = 13;
  config.pin_ws = 12;
  out.begin(config);

  // Setup sine wave
  sineWave.begin(info, N_B4);
  Serial.println("started...");
}

// Arduino loop - copy sound to out 
void loop() {
  copier.copy();
}
