ryfu2/Fall2024ECE445Team33/(commit log)

2024-09-24 Repo Created
    [final_project_v0.1.kicad_pcb, final_project_v0.1.kicad_sch]
2024-12-04 Notebook Update
    [ECE445 Components.xlsx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]
2024-12-04 add documents, wav_receiver python file, and arduino files
    [ECE445 Components.xlsx]
